lidorshimoni/TinyTitan/3d model/README.md

# TinyTitan
A tiny pocket sized affordable robot.
