lidorshimoni/TinyTitan/3d model/Assem3.SLDASM

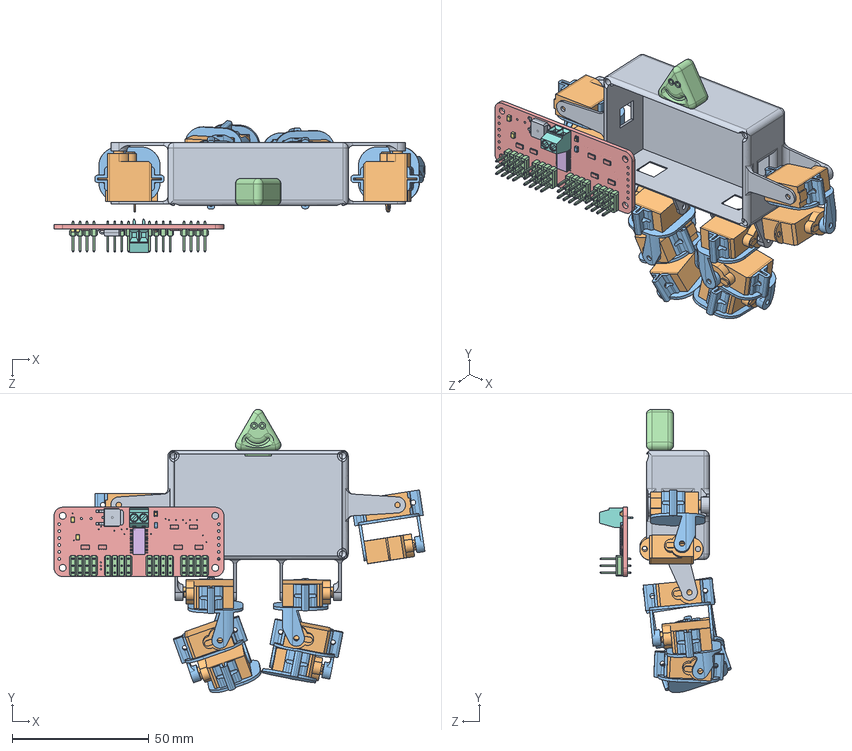
[picture p6: CAD file, 2024-05-03]
3d model/Assem3.SLDASM
135.8 x 103.7 x 48.2 mm
Servo x 10
test_hinge x 8
Board.step
PCA9685.step
10K.step x 2
TERMBLOCK_1X2-3.5MM.step
AOD417.step
GREEN.step
470.step
3X04.step x 4
10K_1.step x 6
