lidorshimoni/TinyTitan/3d model/Servo Motor/Servo.SLDPRT

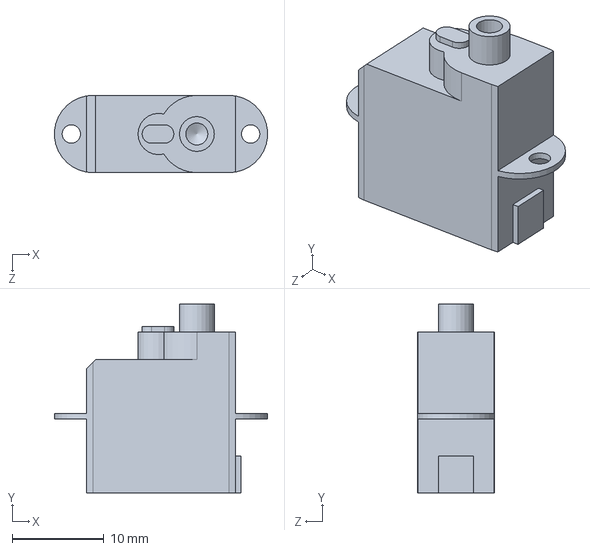
[picture p7: CAD file, 2024-03-13]
3d model/Servo Motor/Servo.SLDPRT
23.2 x 20.5 x 8.40 mm
