lidorshimoni/TinyTitan/3d model/stl_files/V0.4.0/foot.STL

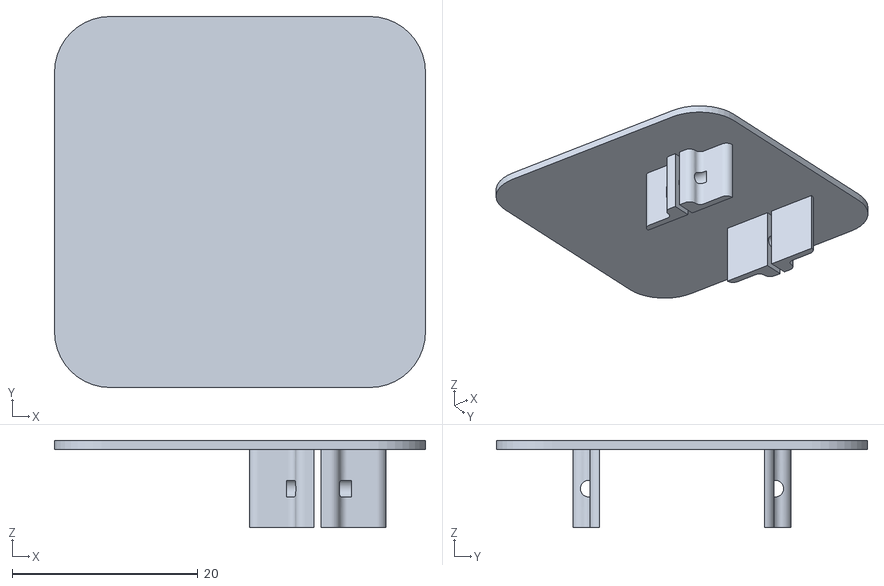
[picture p8: CAD file, 2024-05-03]
3d model/stl_files/V0.4.0/foot.STL
40.0 x 40.0 x 9.40
