lidorshimoni/TinyTitan/3d model/servo driver/815 Servo Driver 16 Channel.step

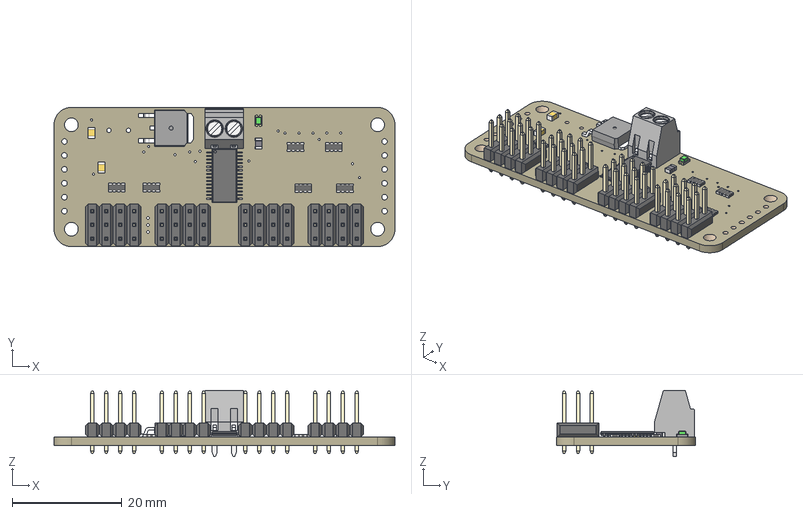
[picture p9: CAD file, 2024-03-04]
3d model/servo driver/815 Servo Driver 16 Channel.step
62.2 x 25.4 x 12.1 mm
Board
PCA9685
10K x 2
TERMBLOCK_1X2-3.5MM
AOD417
GREEN
3X04 x 4
10K_1 x 6
