lidorshimoni/TinyTitan/3d model/stl_files/V0.4.0/test_hinge.STL

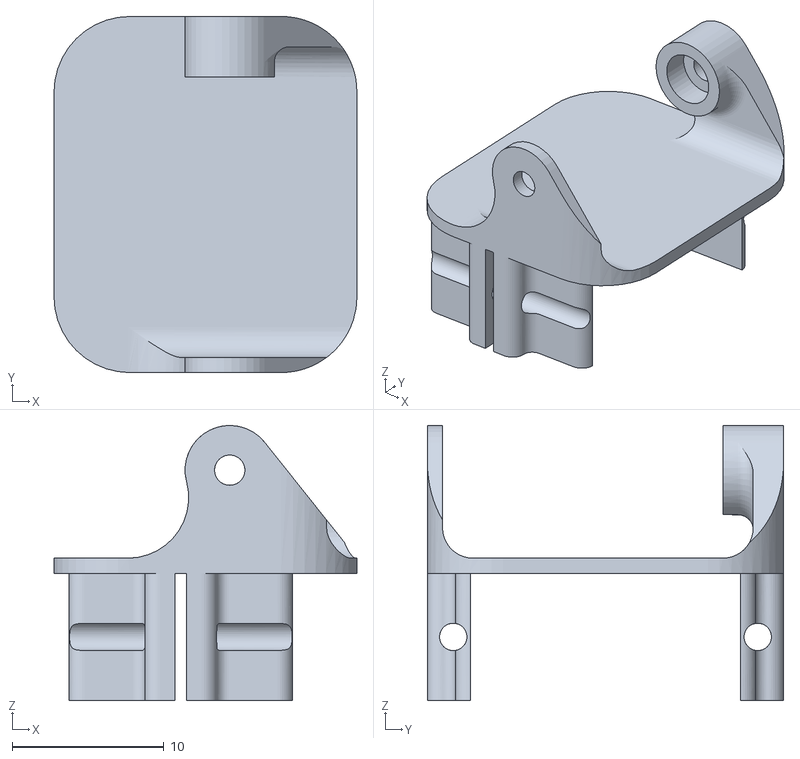
[picture p10: CAD file, 2024-05-03]
3d model/stl_files/V0.4.0/test_hinge.STL
20.0 x 23.5 x 18.2
