lidorshimoni/TinyTitan/3d model/face.SLDPRT

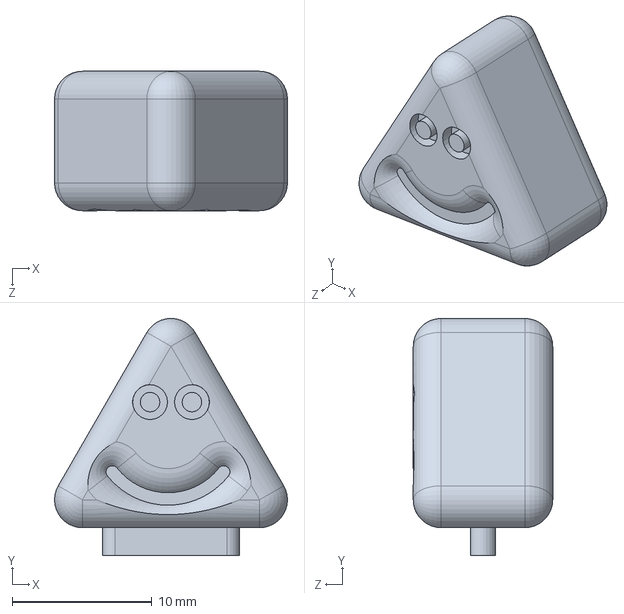
[picture p11: CAD file, 2024-05-03]
3d model/face.SLDPRT
16.7 x 17.0 x 10.0 mm
