lidorshimoni/TinyTitan/3d model/lid.SLDPRT

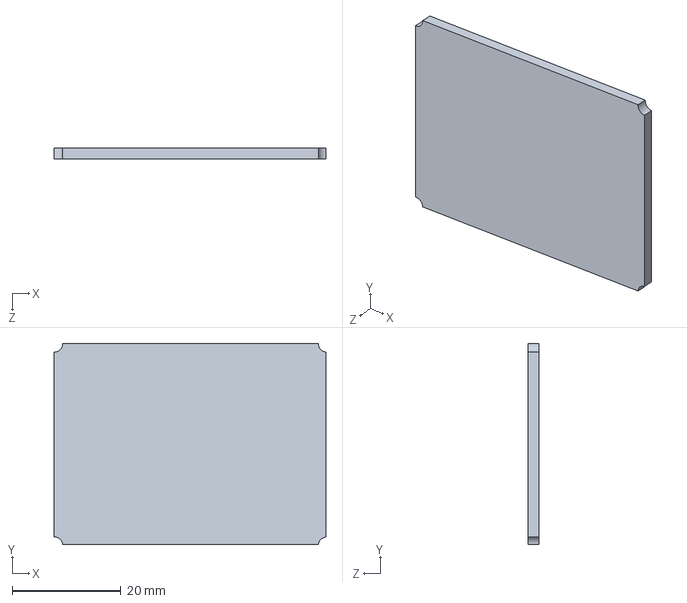
[picture p13: CAD file, 2024-05-03]
3d model/lid.SLDPRT
50.0 x 37.0 x 2.00 mm
