lidorshimoni/TinyTitan/3d model/test_hinge.SLDPRT

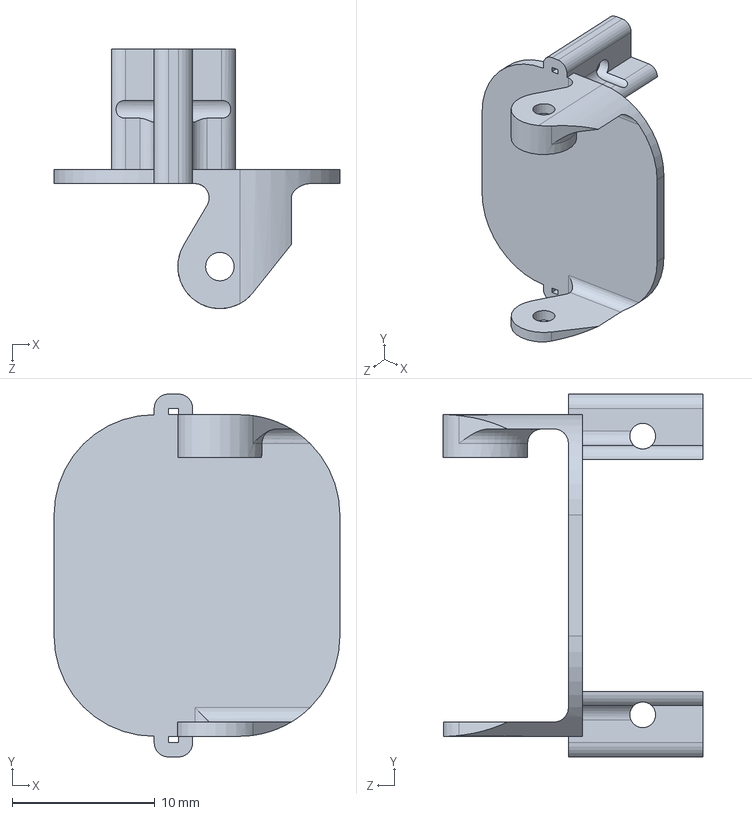
[picture p14: CAD file, 2024-03-13]
3d model/test_hinge.SLDPRT
20.0 x 25.4 x 18.2 mm
