lidorshimoni/TinyTitan/3d model/body.SLDPRT

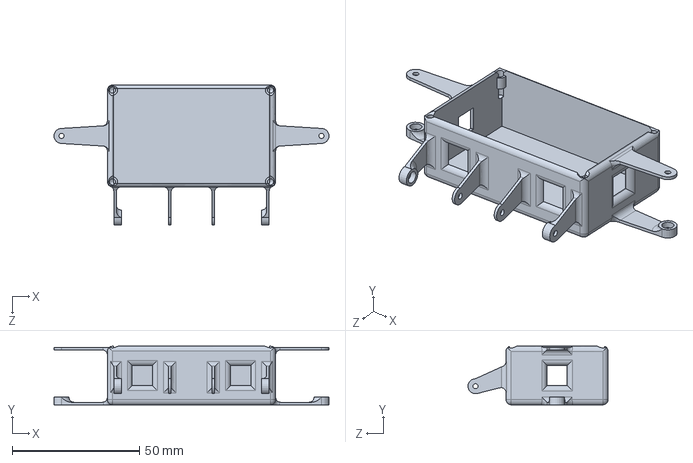
[picture p15: CAD file, 2024-03-13]
3d model/body.SLDPRT
107.9 x 23.0 x 54.9 mm
