lidorshimoni/TinyTitan/3d model/stl_files/V0.4.0/body.STL

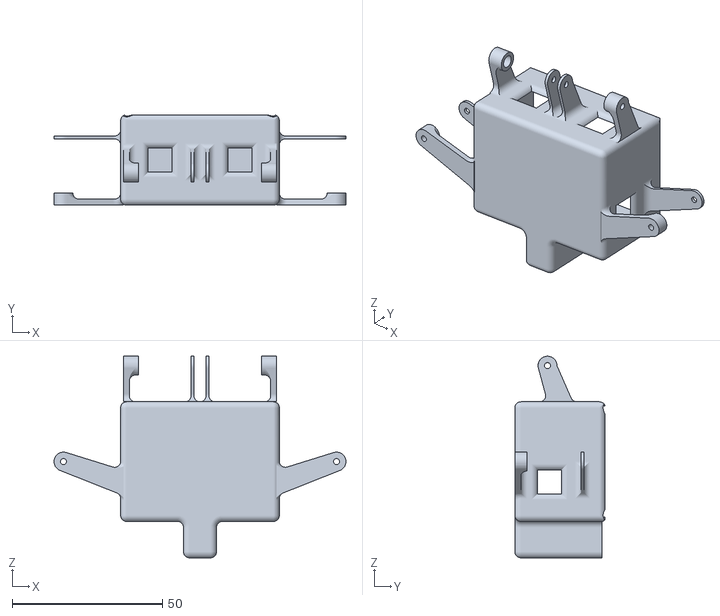
[picture p16: CAD file, 2024-05-03]
3d model/stl_files/V0.4.0/body.STL
97.1 x 30.0 x 67.1
