lidorshimoni/TinyTitan/3d model/stl_files/V0.4.0/small_foot.STL

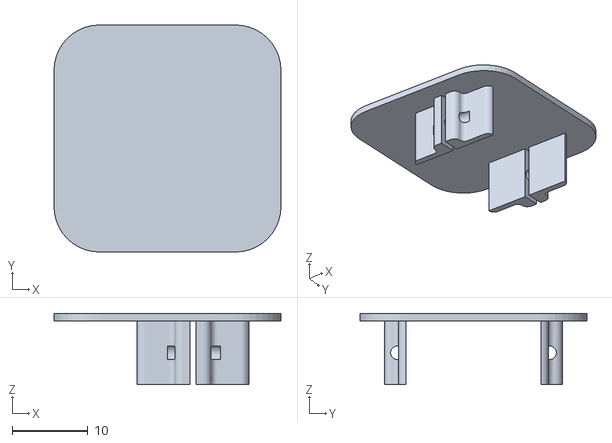
[picture p17: CAD file, 2024-05-03]
3d model/stl_files/V0.4.0/small_foot.STL
30.0 x 30.0 x 9.40
