lidorshimoni/TinyTitan/3d model/Old/Assem2.SLDASM

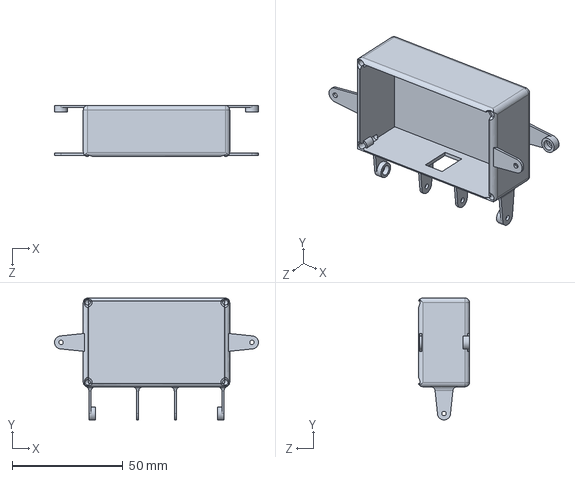
[picture p18: CAD file, 2024-03-13, an earlier design]
3d model/Old/Assem2.SLDASM
91.9 x 55.0 x 23.0 mm
