lidorshimoni/TinyTitan/3d model/stl_files/V0.1.0/test_hinge.STL

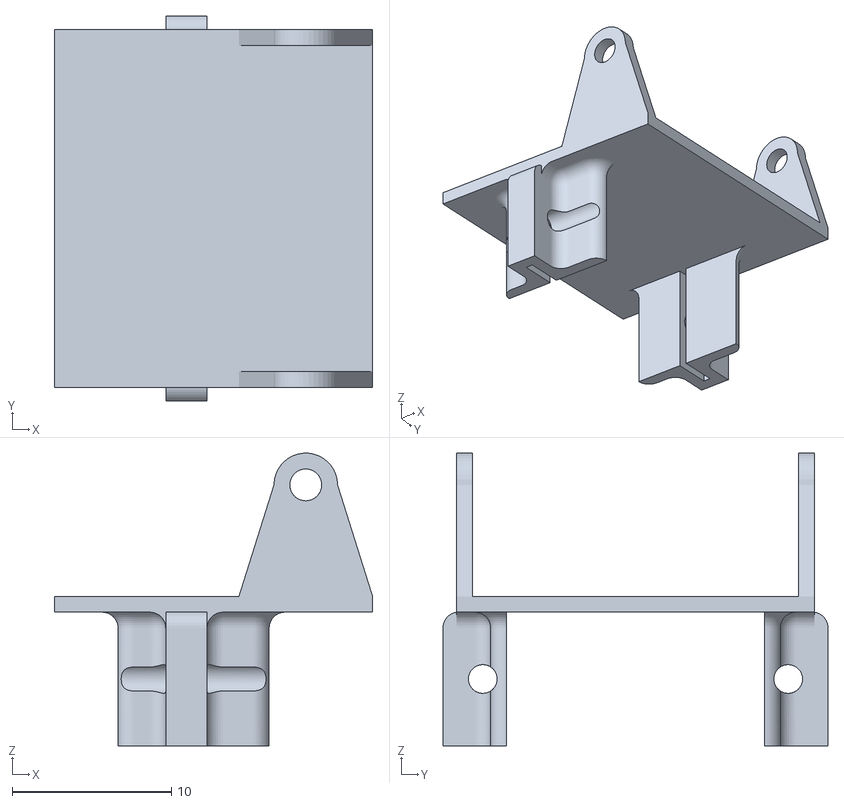
[picture p19: CAD file, 2024-03-04, an earlier design]
3d model/stl_files/V0.1.0/test_hinge.STL
20.0 x 24.2 x 18.4
