lidorshimoni/TinyTitan/(list of files, cad)

Other CAD files:
3d model/servo driver/ESP32-DEVKITC-32D.step.SLDASM
3d model/stl_files/V0.4.0/test_hinge_mirrored.STL
3d model/stl_files/V0.4.0/lid.STL
3d model/stl_files/V0.4.0/test_hinge_long_mirrored.STL
3d model/Servo Motor/Servo.SLDDRW
3d model/body - Copy.SLDPRT
3d model/servo driver/815 Servo Driver 16 Channel.SLDASM
3d model/stl_files/V0.1.0/body.STL
3d model/stl_files/V0.1.0/foot.STL
3d model/stl_files/V0.1.0/long_hinge.STL
3d model/stl_files/V0.1.0/long_hinge_mirrored.STL
3d model/stl_files/V0.1.0/test_hinge(2).STL
3d model/stl_files/V0.1.0/test_hinge(3).STL
3d model/stl_files/V0.1.0/test_hinge(4).STL
3d model/stl_files/V0.1.0/test_hinge(5).STL
3d model/stl_files/V0.1.0/test_hinge_mirrored.STL
3d model/stl_files/v0.2.0/body.STL
3d model/stl_files/v0.2.0/mount.STL
3d model/stl_files/v0.2.0/test_hinge-mirrored.STL
3d model/stl_files/v0.2.0/test_hinge-mirrored_mirrored.STL
3d model/stl_files/v0.2.0/test_hinge.SLDPRT
3d model/stl_files/v0.2.0/test_hinge.STL
3d model/stl_files/v0.2.0/test_hinge_long.STL
3d model/stl_files/v0.3.0/body.STL
3d model/stl_files/v0.3.0/leg.STL
3d model/stl_files/v0.3.0/test_hinge _long_mirrored.STL
3d model/stl_files/v0.3.0/test_hinge.STL
3d model/stl_files/v0.3.0/test_hinge_long.STL
3d model/stl_files/v0.3.0/test_hinge_mirrored.STL
3d model/test_hinge - Copy.SLDPRT
