lidorshimoni/TinyTitan/(commit log)

2024-03-04 Initial commit.
    [815 Servo Driver 16 Channel.SLDASM, 815 Servo Driver 16 Channel.step, Assem1.SLDASM, Assem2.SLDASM, ESP32-DEVKITC-32D.step.SLDASM, Servo.SLDDRW, Servo.SLDPRT, body.SLDPRT]
2024-03-13 Made another assembly, fixed motor positions and moved cable holes
    [Assem2.SLDASM, Assem3.SLDASM, Servo.SLDPRT, body.SLDPRT, test_hinge.SLDPRT]
2024-03-26 added Microcontroller python driver... should work on bluetooth
    [815 Servo Driver 16 Channel.SLDASM, 815 Servo Driver 16 Channel.step, Assem1.SLDASM, Assem2.SLDASM, Assem3.SLDASM, ESP32-DEVKITC-32D.step.SLDASM, Servo.SLDDRW, Servo.SLDPRT]
2024-05-03 improved walking ability
    [Assem3.SLDASM, body - Copy.SLDPRT, body.STL, face.SLDPRT, foot.STL, leg.STL, lid.SLDPRT, lid.STL]
